DulajBopitiya/Microbot/README.md

# About this page

This includes every updates and code info.
make a brach or pull request of needed.
