DulajBopitiya/Microbot/(list of files, drawings)

Other design files:
Main pcb design/Altium/Main_schematic/Main_schematic.PrjPcb
Main pcb design/Altium/Main_schematic/Schlib1.SchLib
Main pcb design/Altium/Main_schematic/Sheet1.SchDoc
