DulajBopitiya/Microbot/(commit log)

2023-12-18 Add sample
    cibeuiv
2024-01-16 deleted ReadME2.md and sample.py
